thanhlam1723/CNC-Multi-Parameter-Monitoring/Documents/Diagrams/node_chậm.drawio.png

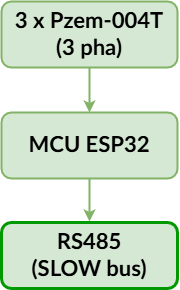
Documents/Diagrams/node_chậm.drawio.png
