thanhlam1723/CNC-Multi-Parameter-Monitoring/(commit log)

2026-06-09 Rename node chậm.drawio.png to node_chậm.drawio.png
2026-06-09 Rename sơ đồ tổng quan.drawio.svg to Sơ_đồ_tổng_quan.drawio.svg
